arantius/remapcro/README.md

The remapcro is a hardware device for storing and replaying keyboard macros.

For more detail see: https://making.arantius.com/remapcro
