arantius/remapcro/case/skp/hw_key.png

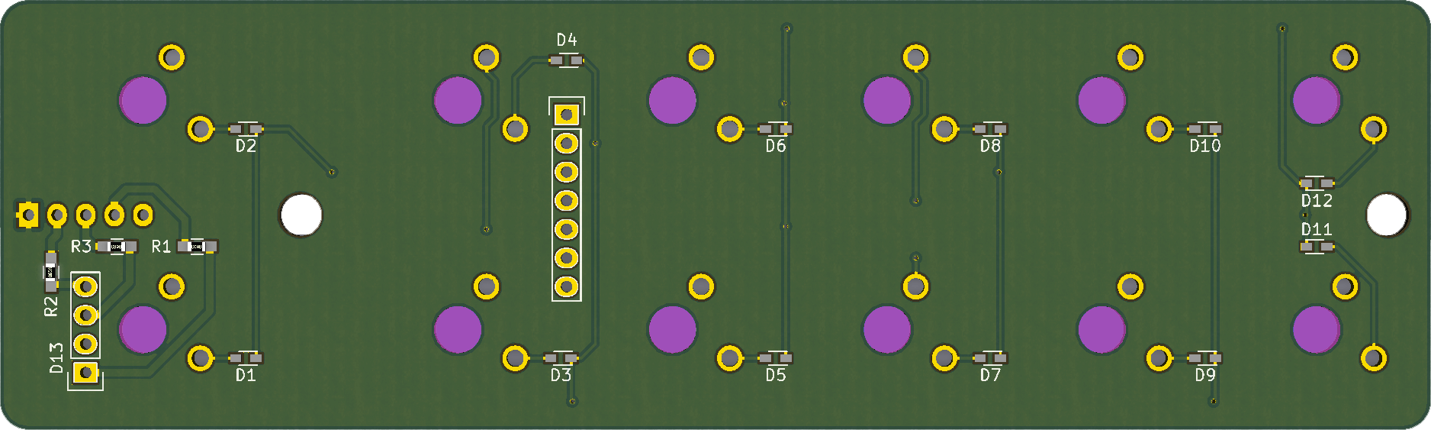
case/skp/hw_key.png
