arantius/remapcro/case/skp/hw_key_bot.png

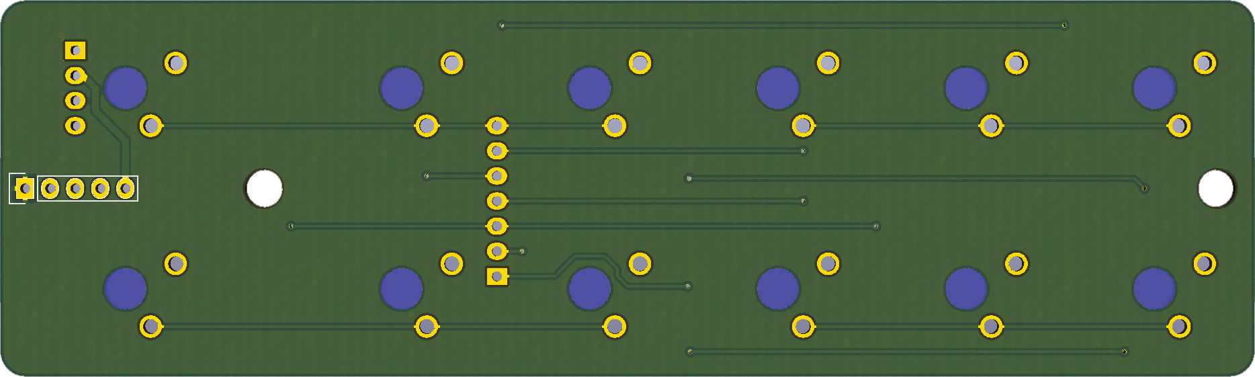
case/skp/hw_key_bot.png
