arantius/remapcro/case/skp/hw_logic.png

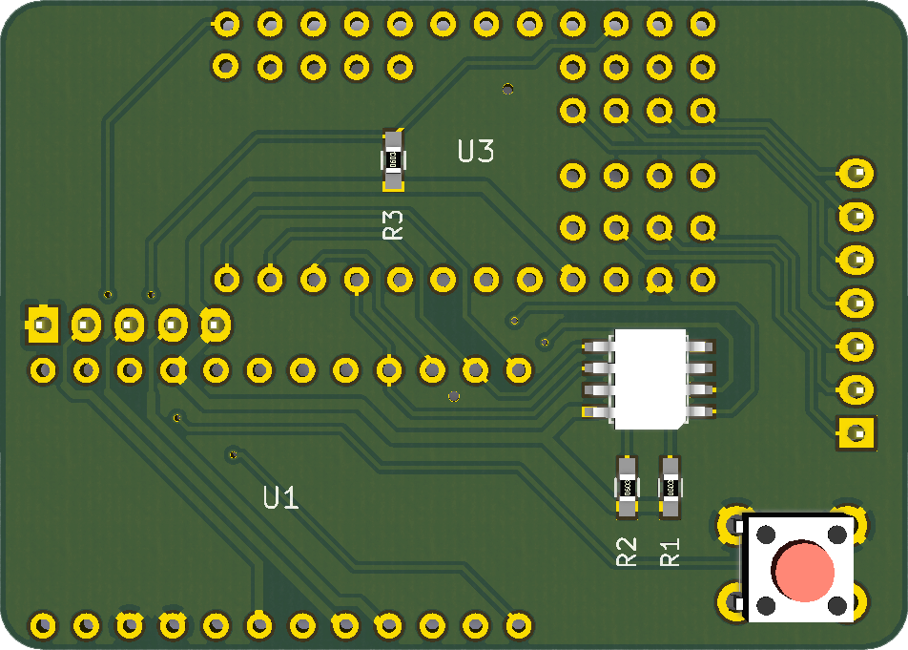
case/skp/hw_logic.png
