arantius/remapcro/case/case-bottom.stl

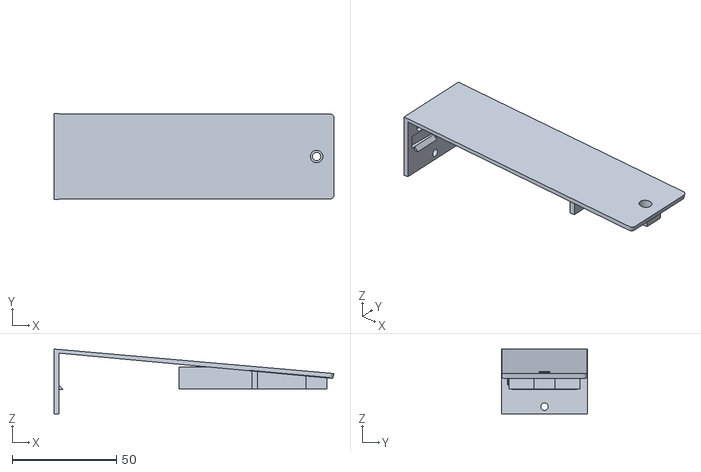
[picture p4: CAD file, 2017-01-30]
case/case-bottom.stl
134.0 x 41.0 x 31.1
