arantius/remapcro/case/case-top.stl

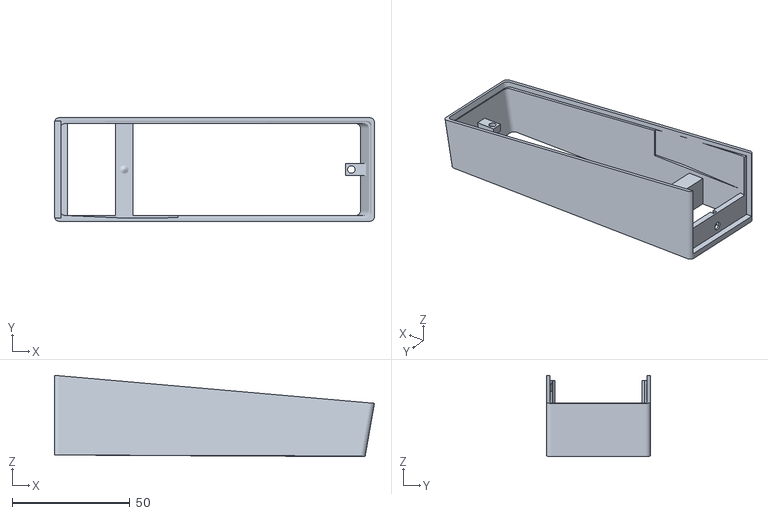
[picture p5: CAD file, 2017-01-30]
case/case-top.stl
135.7 x 44.0 x 34.5
