arantius/remapcro/(list of files, cad)

Other CAD files:
case/skp/case-twopiece.skp
case/skp/case.skp
