arantius/remapcro/hw_logic/hw_logic.kicad_pcb

## KiCad design hw_logic/hw_logic.kicad_pcb (2017-01-29)

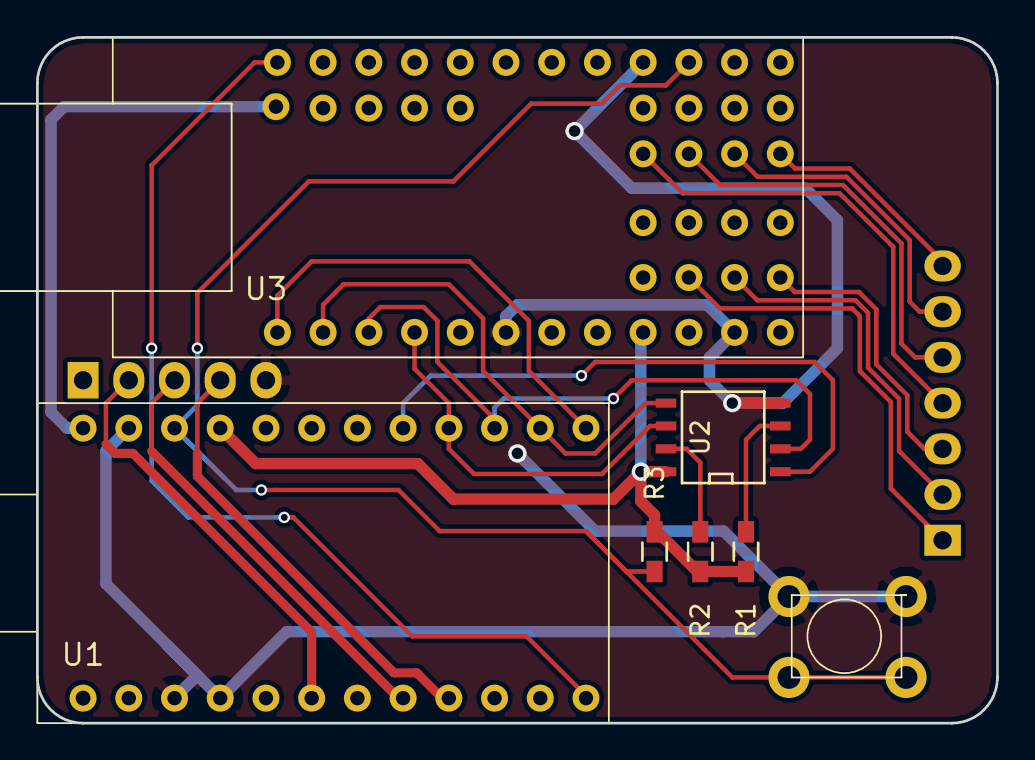
[picture p6: board hw_logic.kicad_pcb from above]

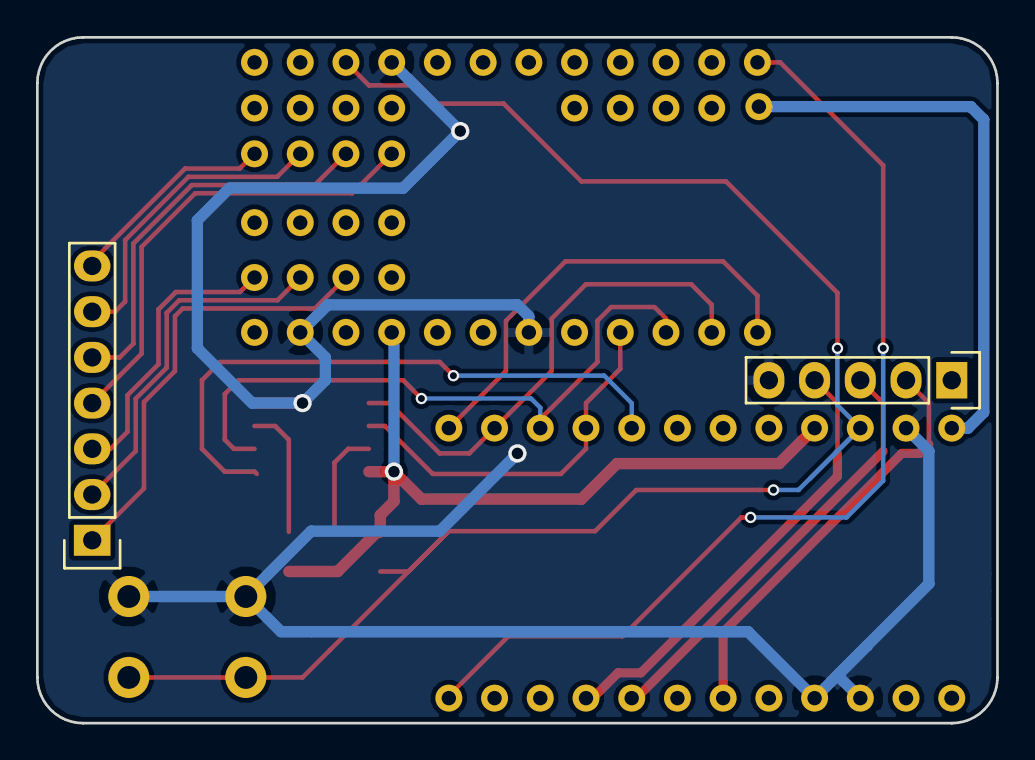
[picture p7: board hw_logic.kicad_pcb from below]

Board: 2 copper layers, 53.3 x 38.1 mm, 9 parts (2 on the bottom side), 22 nets.

Parts:
P1: CONN_01X05; Pin_Header_Straight_1x05
P2: CONN_01X07; Pin_Header_Straight_1x07
R1, R2, R3: 4k7; R_0603_HandSoldering
SW13: SW_PUSH; SW_TACTILE_THT
U1: LEO_PRO_MICRO
U2: IS25LQ; SOIC-8-N
U3: USB_HOST_SHIELD_MINI; UHS_MINI

Connections:
+3V3: R1.1, R2.1, R3.1, U1.21, U2.8, U3.9
+5V: U1.24, U3.25
/FLASH_SS: U1.17, U2.1
/GI0: P2.3, U3.30
/GI1: P2.2, U3.31
/GI2: P2.1, U3.32
/GO0: P2.7, U3.38
/GO1: P2.6, U3.39
/GO2: P2.5, U3.40
/GO3: P2.4, U3.41
/LED_B: P1.2, U1.6
/LED_G: P1.3, U1.8
/LED_R: P1.4, U1.9
/MISO: U1.15, U2.2, U3.3
/MOSI: U1.14, U2.5, U3.2
/RST: R3.2, SW13.1, U1.22, U3.15
/SCK: U1.16, U2.6, U3.4
/USB_INT: U1.12, U3.24
/USB_SS: U1.13, U3.1
GND: P1.5, SW13.2, U1.3, U1.4, U1.23, U2.4, U3.6, U3.11, U3.16
unnamed: R1.2, U2.3
unnamed: R2.2, U2.7
