arantius/remapcro/hw_key/hw_key.kicad_pcb

## KiCad design hw_key/hw_key.kicad_pcb (2017-01-07)

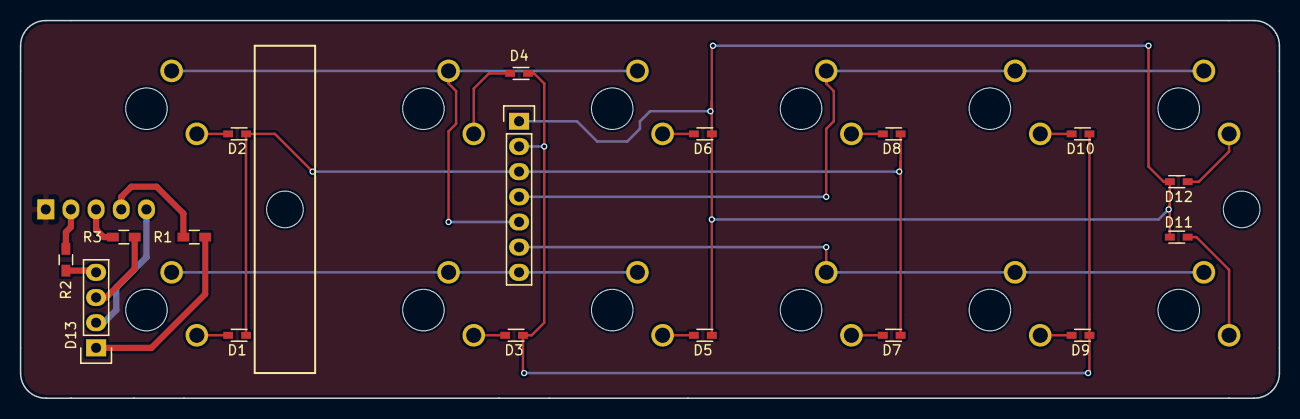
[picture p8: board hw_key.kicad_pcb from above]

Board: 2 copper layers, 127.0 x 38.1 mm, 30 parts (1 on the bottom side), 26 nets.

Parts:
D1, D2, D3, D4, D5, D6, D7, D8, D9, D10, D11, D12: D; SOD-523-handsoldering
D13: LED_RABG; Pin_Header_Straight_1x04
P1: CONN_01X07; Pin_Header_Straight_1x07
P2: CONN_01X05; Pin_Header_Straight_1x05
R1, R2, R3: 330; R_0603_HandSoldering
SW1, SW2, SW3, SW4, SW5, SW6, SW7, SW8, SW9, SW10, SW11, SW12: SW_PUSH_SMALL_H; CHERRY_MX

Connections:
+3V3: D13.2, P2.5
/LED_B: P2.2, R2.2
/LED_G: P2.3, R3.2
/LED_R: P2.4, R1.2
/kC0: P1.7, SW1.1, SW3.1, SW5.1
/kC1: P1.6, SW7.1, SW9.1, SW11.1
/kC2: P1.5, SW2.1, SW4.1, SW6.1
/kC3: P1.4, SW8.1, SW10.1, SW12.1
/kR0: D1.1, D2.1, D7.1, D8.1, P1.3
/kR1: D3.1, D4.1, D9.1, D10.1, P1.2
/kR2: D5.1, D6.1, D11.1, D12.1, P1.1
unnamed: D1.2, SW1.2
unnamed: D2.2, SW2.2
unnamed: D3.2, SW3.2
unnamed: D4.2, SW4.2
unnamed: D5.2, SW5.2
unnamed: D6.2, SW6.2
unnamed: D7.2, SW7.2
unnamed: D8.2, SW8.2
unnamed: D9.2, SW9.2
unnamed: D10.2, SW10.2
unnamed: D11.2, SW11.2
unnamed: D12.2, SW12.2
unnamed: D13.1, R1.1
unnamed: D13.3, R3.1
unnamed: D13.4, R2.1
