arantius/remapcro/(commit log)

2016-08-16 Initial basic USB host demo.
    Just dumps HID data to Serial, and twiddles LEDs.
2016-09-10 Independent software.
    Forwards USB keyboard, reads and prints matrix.
2016-09-22 Beginning framework for macro recording.
2016-12-16 first hardware commit
    component for UHS mini
    [remapcro_hw.kicad_pcb, remapcro_hw.sch]
2016-12-16 faster replay, light led during
2016-12-16 don't wait forever for serial
    wait a little while, in case I'm really interested, but give up so the
    keyboard features will work even if I never open the serial port
2016-12-16 debug command for dumping current report
2016-12-16 add some footprints, bare schematic
    [remapcro_hw.sch]
2016-12-16 tiny schematic tweaks
    [remapcro_hw.sch]
2016-12-16 cherry mx switches added
    [remapcro_hw.sch]
2016-12-16 fix uhs mini footprint pin numbers
2016-12-16 circular pads
    [remapcro_hw.kicad_pcb, remapcro_hw.sch]
2016-12-16 rst switch, pcb layout
    [remapcro_hw.kicad_pcb, remapcro_hw.sch]
2016-12-16 more pcb layout
    probably fab as two separate boards!
    [remapcro_hw.kicad_pcb, remapcro_hw.sch]
2016-12-16 pin/net fixes
    custom component, bad definitions
    [remapcro_hw.sch]
2016-12-29 tweaks including hand-solderable SMD diode
    [remapcro_hw.kicad_pcb, remapcro_hw.sch]
2016-12-29 Split logic & key boards to separate projects.
    [hw_key.kicad_pcb, hw_key.sch, hw_logic.kicad_pcb, hw_logic.sch, remapcro_hw.kicad_pcb, remapcro_hw.sch]
2016-12-29 misc, rst button 3d model
    [hw_key.kicad_pcb, hw_logic.kicad_pcb, hw_logic.sch]
2016-12-29 clean up traces, ground fills
    [hw_logic.kicad_pcb]
2017-01-01 mounting holes
    [hw_key.kicad_pcb, hw_logic.kicad_pcb]
2017-01-01 resolve mysterious scope problem
    [UsbDev.h, UsbDev.ino]
2017-01-02 correct pin layouts
    as per breadboard test
    [hw_key.kicad_pcb, hw_logic.kicad_pcb, hw_logic.sch]
2017-01-02 hole position, corner rounding size
    [hw_key.kicad_pcb]
2017-01-04 revamp boards (for assembled height)
    flip logic over so that it can mate closely with key; reset button moves
    to same side as all the other parts; board assembly down to ~16mm high
    and assembly more easily lends itself to angling for even less height at
    the front for slightly more in the back
    [hw_key.kicad_pcb, hw_key.sch, hw_logic.kicad_pcb, hw_logic.sch]
2017-01-07 final PCB revisions
    plus the start of a case to hold them
    [case.skp, front-support.stl, hw_key.kicad_pcb, hw_logic.kicad_pcb]
2017-01-20 case designs in three and two parts
    for 3D printing
    [back.stl, case-twopiece-bot.stl, case-twopiece-top.stl, case-twopiece.skp, case-twopiece.stl, case.skp, case.stl]
2017-01-20 Notes from first assembly.
    Issues discovered + tweaked LED current limiting resistors based on observation. (Duh, the colors have different forward voltages, need different resistor values.)
    [hw_key.sch]
2017-01-20 Update for real hardware.
    * Key layout: two columns of six keys.
    * Pins for LED and chip enable(s).
    * (Basic) RGB led support.
    * Flash chip test output at init.
2017-01-21 tweaked case files
    fits the original misaligned PCB, except I had to cut a bit off the
    bottom of the back piece (!?)
    measuring along the height of the back of the main case I get 30.4mm
    with my calipers, but the sketchu model height is 31.9 -- 1.5mm more,
    just about exactly what I cut off.
    hard to explain; my 3d printer's Z is miscalibrated?
    [back.stl, case.skp, front-support.stl]
2017-01-24 Init KeyboardPlus in UsbDev::init().
    It's part of being the USB device, after all.
2017-01-24 Don't twiddle the built in LED on USB activity.
2017-01-24 syntax error: missing close paren
    [Flash.ino]
2017-01-29 OpenSCAD case.
    Beginnings.
    [case.scad, top.scad]
2017-01-29 More case details.
    Holes in mock key PCB, peg and support line up, PCB to module.
    [case.scad, key_pcb.scad, top.scad]
2017-01-29 Case top: misaligned PCB workaround, bottom place inset.
    [top.scad, wall_shape.scad]
2017-01-29 rename key_pcb.scad -> pcbs.scad
    [case.scad, pcbs.scad]
2017-01-29 Case: Also model logic PCB position.
    [case.scad, pcbs.scad]
2017-01-29 Logic PCB: Fix connector P2 position, swap LED power line.
    A better fix would also swap around the LED on the "key" board, but this reduces bodge needs without respinning that board.
    [hw_logic.kicad_pcb, hw_logic.sch]
2017-01-29 Sub-boards on silkscreen layer.
    [hw_logic.kicad_pcb]
2017-01-29 Remove sketchup based case models.
    [back.stl, case-twopiece-bot.stl, case-twopiece-top.stl, case-twopiece.skp, case-twopiece.stl, case.skp, case.stl, front-support.stl]
2017-01-30 Finish bottom, including holes.
    [bottom.scad, case.scad, top.scad, wall_shape.scad]
2017-01-30 tweak bottom overhang, generate STLs
    [bottom.scad, case-bottom.stl, case-top.stl, top.scad]
2017-01-30 Fix screw head hole, broken by height adjustment.
    [bottom.scad, case-bottom.stl]
2017-02-14 Properly release keys in macro replay.
    If the order is ABABBB that means: press A, press B, release A, release B, press B, release B.
    Before this, the second B would be pressed into the slot just released for the A, rather than releasing the existing pressed B.
2017-03-20 Revert "Remove sketchup based case models."
    At least for my first skewed boards, it might still work better.
    [case-twopiece.skp, case.skp]
